Waelalzoub1/custom-16bit-CPU/docs/img/ALU.png

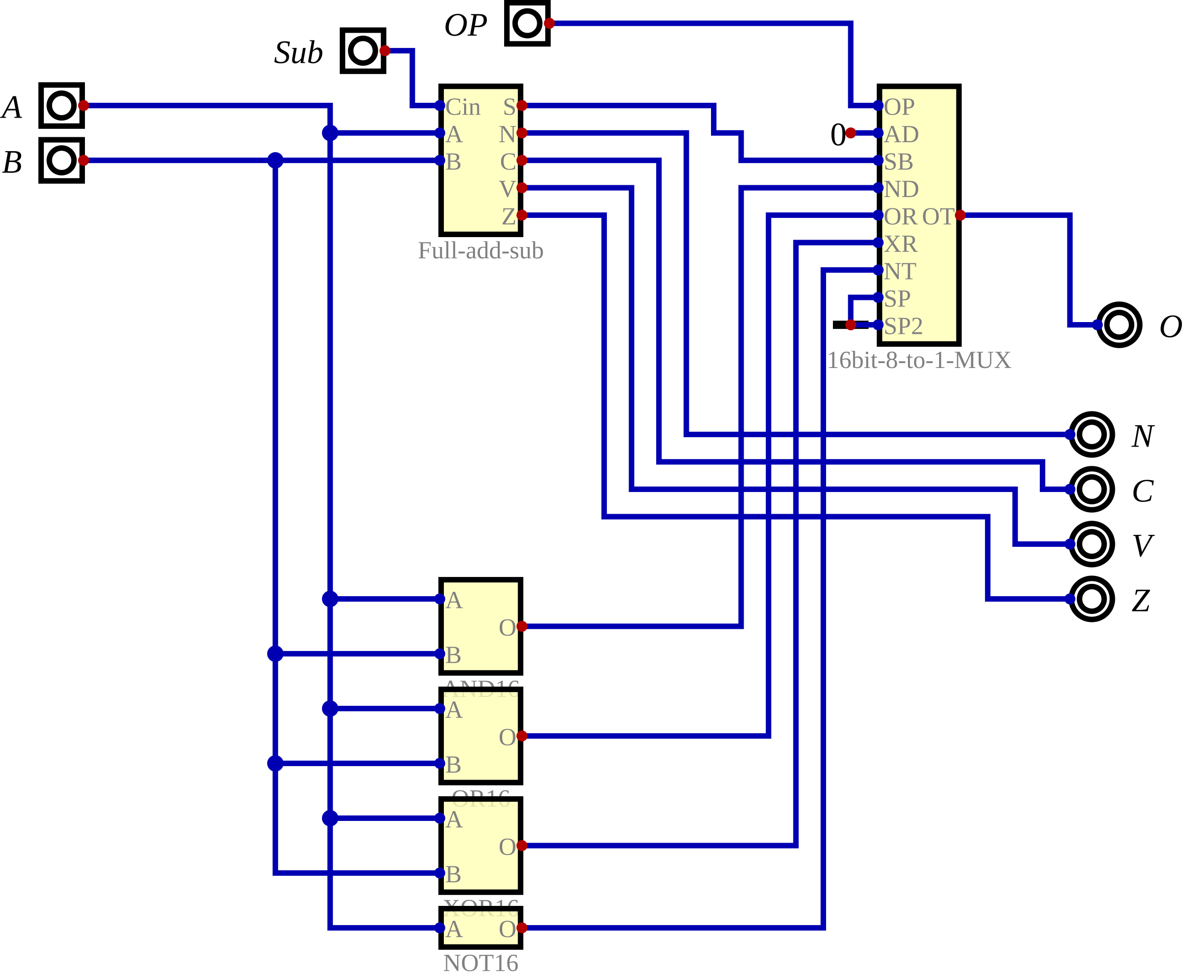
docs/img/ALU.png
