Waelalzoub1/custom-16bit-CPU/docs/img/control.png

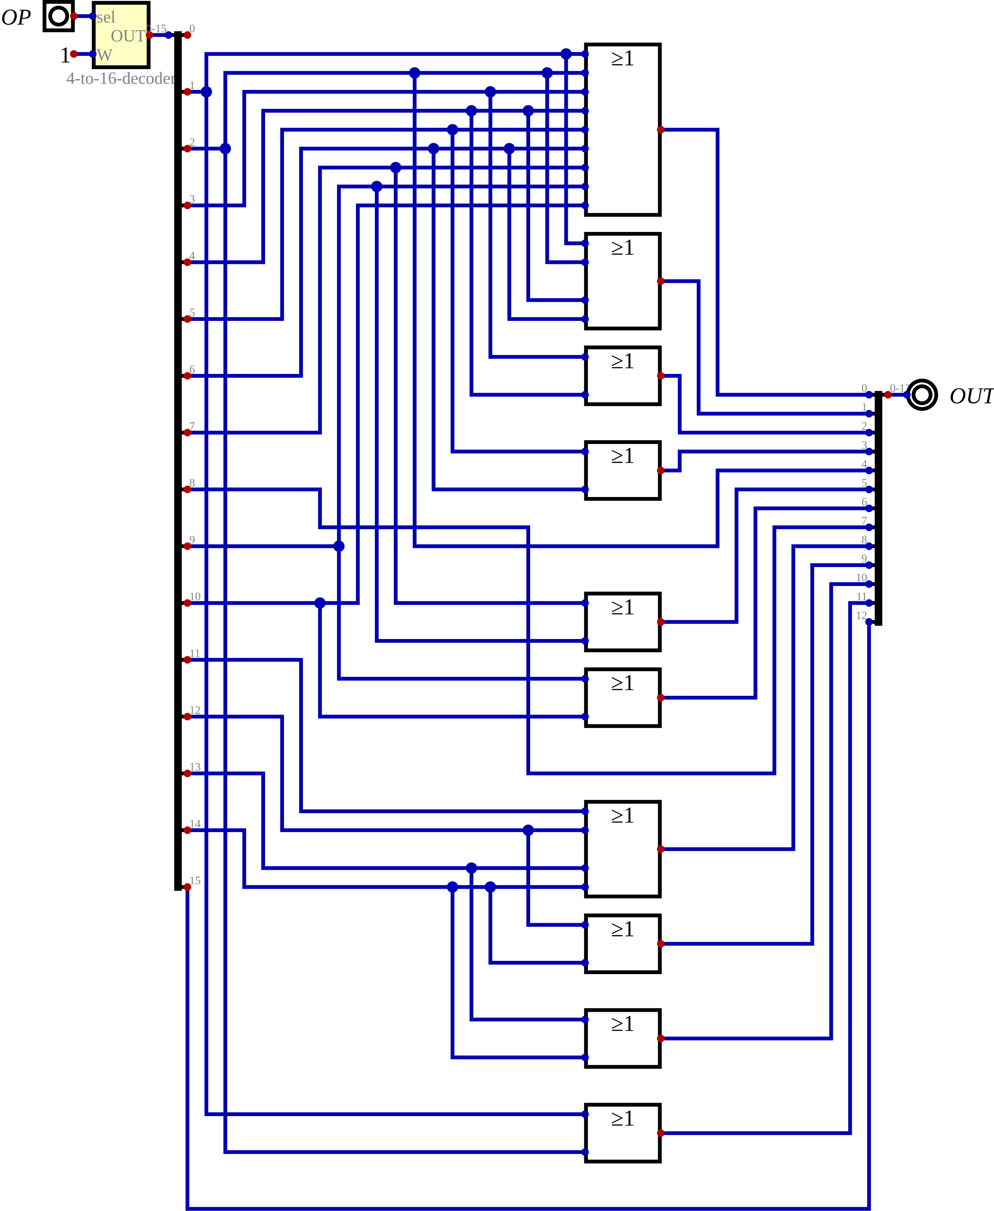
docs/img/control.png
