Waelalzoub1/custom-16bit-CPU/docs/img/NAND_transistor.png

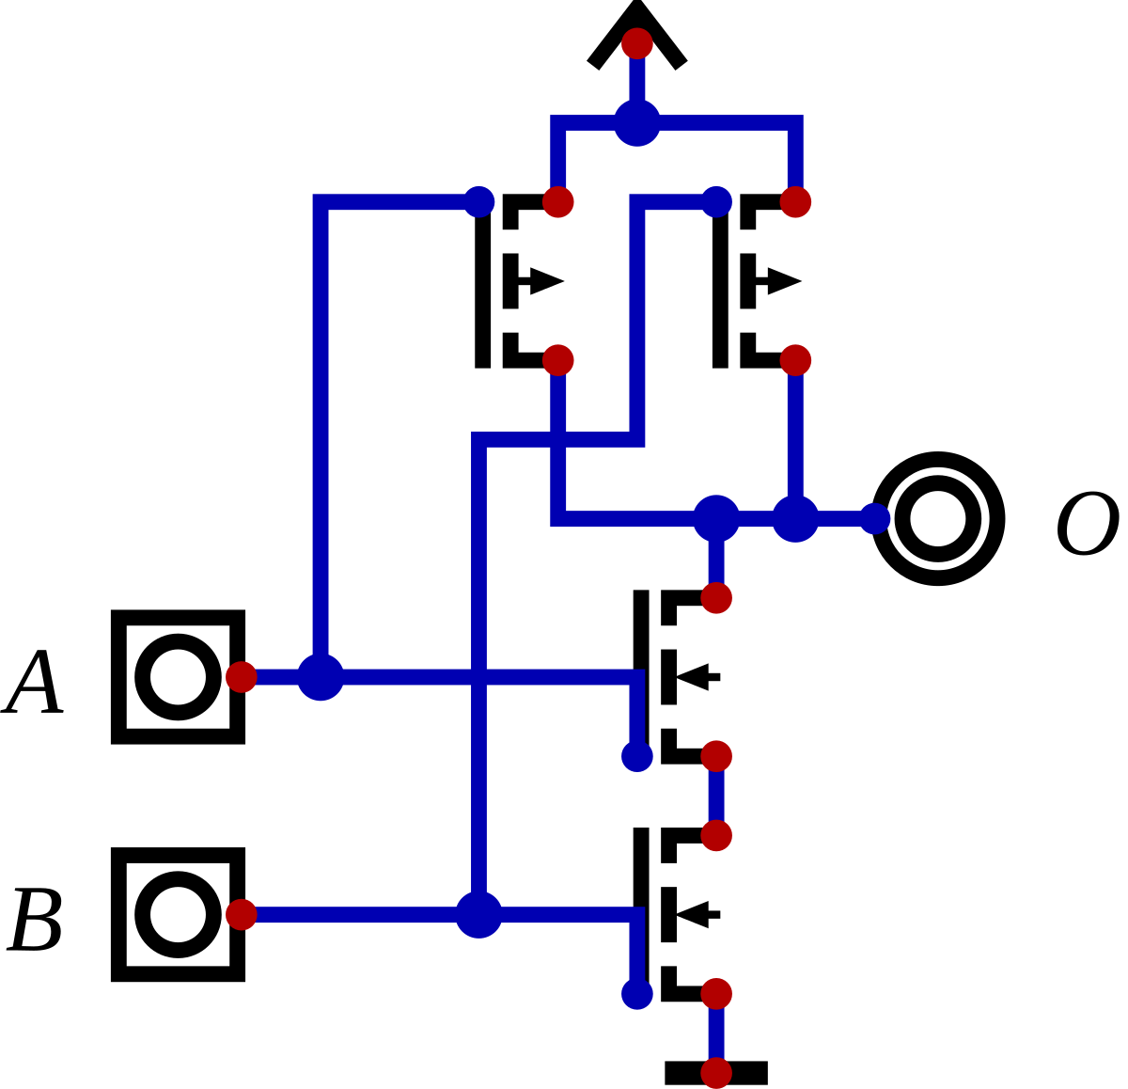
docs/img/NAND_transistor.png
