Waelalzoub1/custom-16bit-CPU/docs/img/Program Counter.png

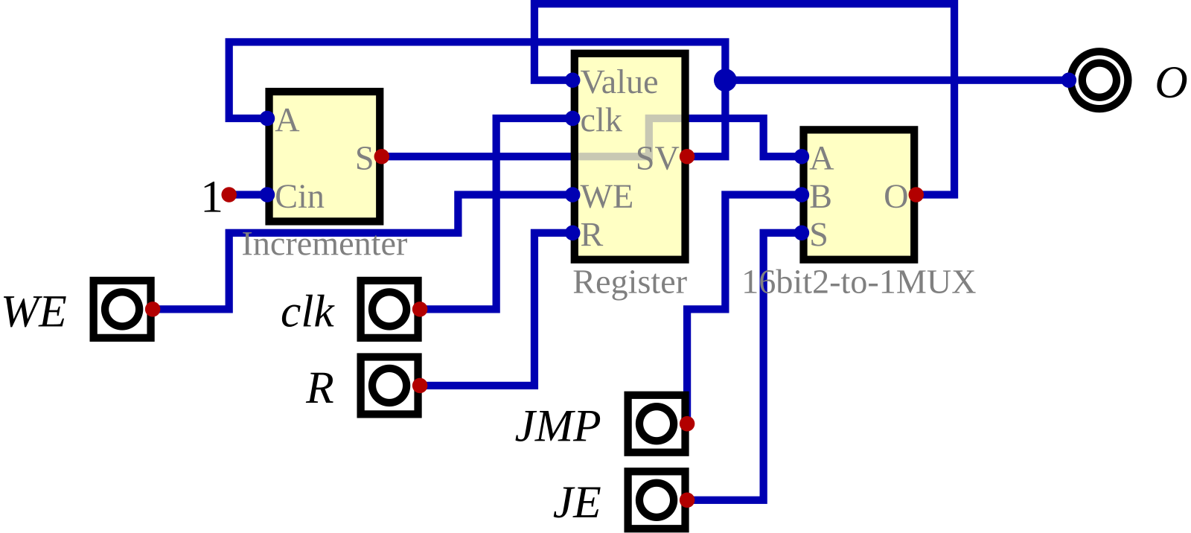
docs/img/Program Counter.png
