Waelalzoub1/custom-16bit-CPU/docs/img/Register.png

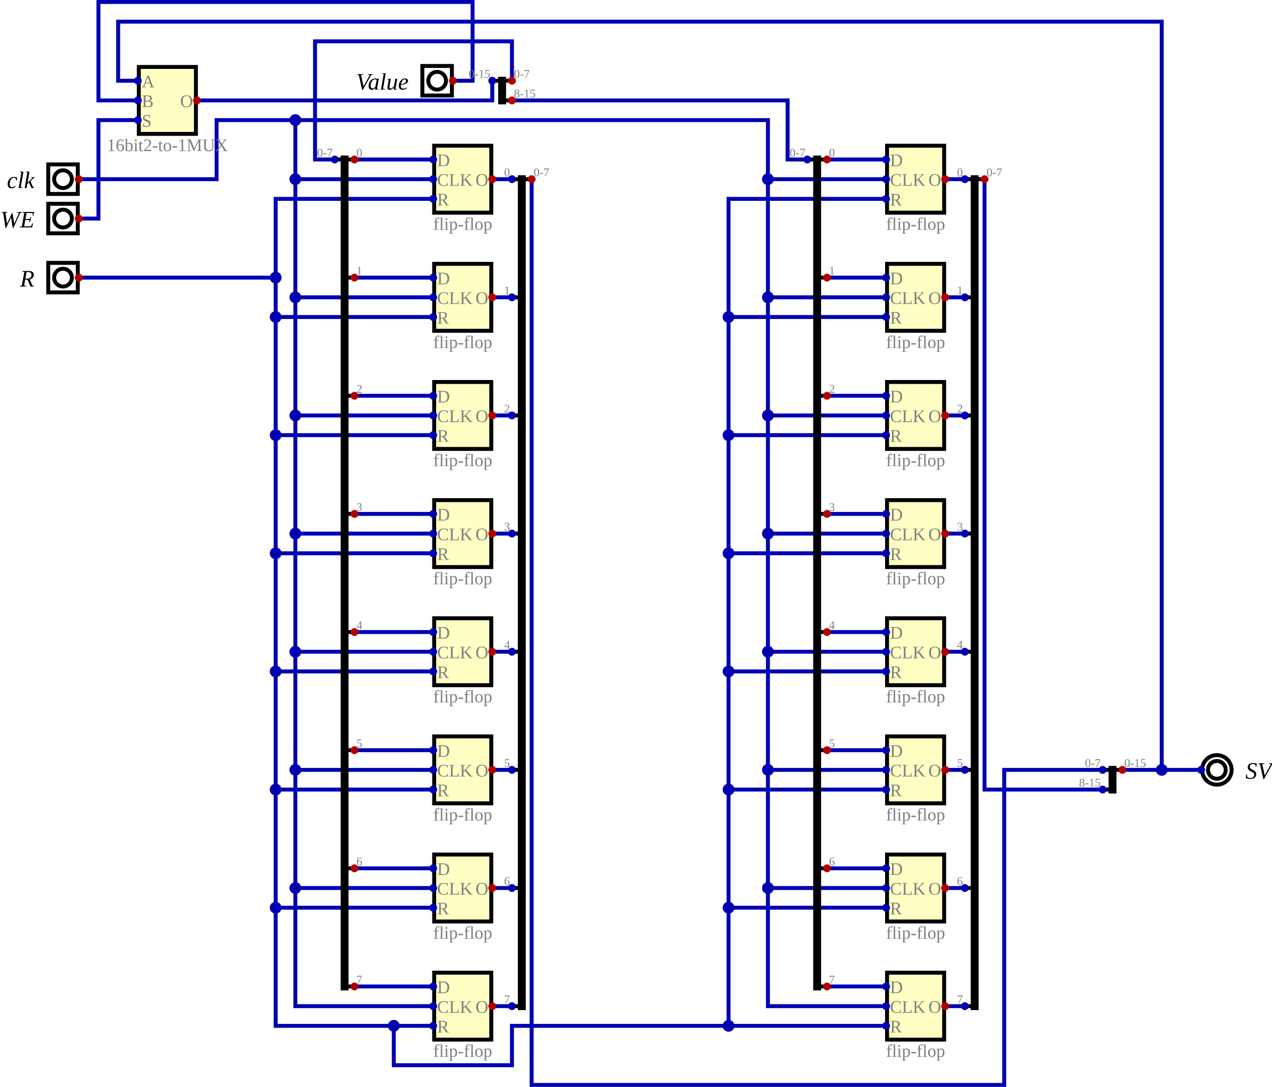
docs/img/Register.png
