Waelalzoub1/custom-16bit-CPU/docs/img/sky130_layout_zoom.jpg

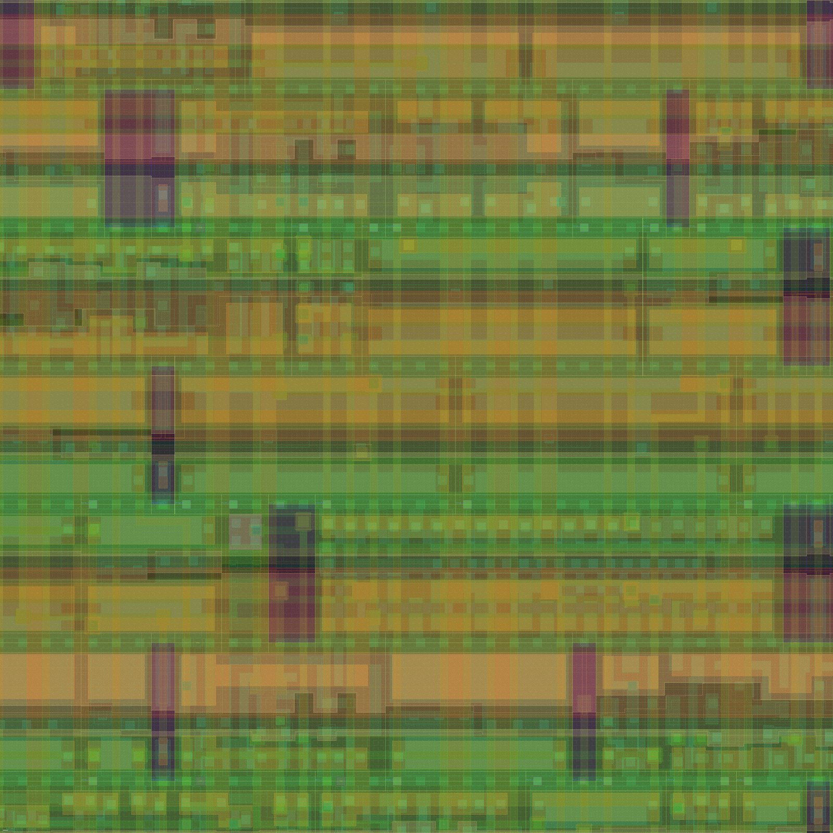
docs/img/sky130_layout_zoom.jpg
