Waelalzoub1/custom-16bit-CPU/asic/openlane_run1_metrics.csv

design | design_name | config | flow_status | total_runtime | routed_runtime | (Cell/mm^2)/Core_Util | DIEAREA_mm^2 | CellPer_mm^2 | OpenDP_Util | Final_Util | Peak_Memory_Usage_MB | synth_cell_count | tritonRoute_violations | Short_violations | MetSpc_violations | OffGrid_violations | MinHole_violations | Other_violations | Magic_violations | pin_antenna_violations | net_antenna_violations | lvs_total_errors | cvc_total_errors | klayout_violations | wire_length | vias | wns | pl_wns | optimized_wns | fastroute_wns | spef_wns | tns | pl_tns | optimized_tns | fastroute_tns | spef_tns | HPWL | routing_layer1_pct | routing_layer2_pct | routing_layer3_pct | routing_layer4_pct | routing_layer5_pct | routing_layer6_pct | wires_count | wire_bits | public_wires_count | public_wire_bits | memories_count | memory_bits | processes_count | cells_pre_abc | AND | DFF | NAND | NOR | OR | XOR | XNOR | MUX
/openlane/designs/cpu | CPU_export | run1 | flow completed | 0h17m52s0ms | 0h13m12s0ms | 106889.53838443654 | 1.069665018 | 26722.384596109136 | 25.54 | -1 | 3227.14 | 23405 | 0 | 0 | 0 | 0 | 0 | 0 | 0 | 328 | 200 | 0 | -1 | -1 | 2089262 | 219978 | 0.0 | -1 | -1 | -1 | 0.0 | 0.0 | -1 | -1 | -1 | 0.0 | 1480498788.0 | 0.0 | 45.88 | 48.71 | 31.22 | 37.51 | 18.75 | 15075 | 21172 | 5415 | 11512 | 0 | 0 | 0 | 14149 | 27 | 1 | 15 | 26 | 355 | 57 | 25 | 8768
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
