Waelalzoub1/custom-16bit-CPU/docs/img/Instruction reader.png

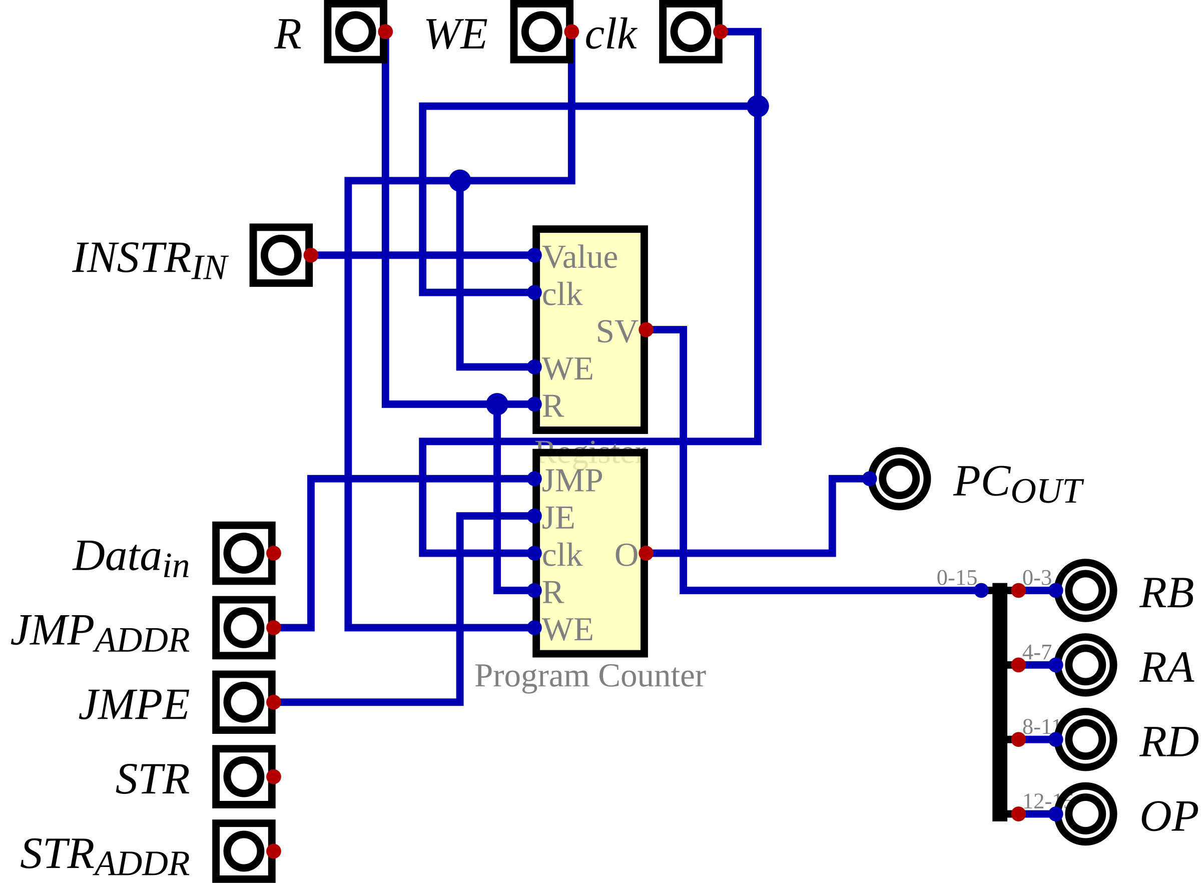
docs/img/Instruction reader.png
