Waelalzoub1/custom-16bit-CPU/(commit log)

2026-09-20 Add assembler, programs, Icarus simulation, synthesis evidence, and an accurate README
    - asm/asm.py: two-pass assembler per ASSEMBLER_SPEC.md with unit tests
    - programs/: fib, shift-add multiply, bubble sort, framebuffer diagonal, with expected final state
    - sim/: Icarus Verilog testbench and runner; all four programs pass on CPU_export.v
    - asic/: Yosys generic synthesis script and the OpenLane sky130 run reports (DRC/LVS clean, antenna/slew not)
    - docs/img: schematics exported with Digital's CLI, sky130 layout
    - README: states which blocks are NAND-built vs Digital built-ins, the HLT mismatch in the export, measured numbers only
    - LICENSE (MIT), .gitignore
    [openlane_run1_metrics.csv]
2026-09-21 sim: detect a real halt, look up Digital's instance names, release reset away from the clock edge
    [run_sim.py, tb.v]
2026-09-21 README, schematics and synthesis stats for the HLT revision
